chenljjj/stm32-env-monitor/docs/03-STM32与ESP32串口协议与调试.md

# STM32—ESP32 UART 协议与联调记录

本文档名使用中文，内容中的协议字段仍保留英文标识以匹配源码。

本文记录 `stm32-env-monitor` 当前使用的二进制 UART 协议、实际接线、ACK/网络状态机制和实测调试过程。STM32 负责采样和本地显示；ESP32 负责网关处理，并将有效采样加入 FreeRTOS 队列后交给 MQTT/TLS 模块。

STM32 侧现同样运行 FreeRTOS：`SensorTask` 将采样快照投递给 `LinkTask`，由后者负责协议发送、ACK 解析后的状态维护与超时重传。因此采样与通信恢复过程不会阻塞 OLED 刷新。

## 1. 通信通道与接线

两个 UART 通道相互独立：

```text
STM32 USART2 (PA2/PA3) ←→ CH340 / PC 文本日志
STM32 USART1 (PA9/PA10) ←→ ESP32 UART2 (GPIO25/GPIO26) 二进制协议
ESP32 UART0 (GPIO1/GPIO3) ←→ CP2102 / PC 烧录和日志
```

| 信号 | STM32F103C8T6 | ESP32 DevKitC | 方向 |
| --- | --- | --- | --- |
| 数据发送 | PA9 / USART1_TX | GPIO25 / UART2_RX | STM32 → ESP32 |
| 数据返回 | PA10 / USART1_RX | GPIO26 / UART2_TX | ESP32 → STM32 |
| 参考地 | GND | GND | 双向共地 |

双方均采用 `115200-8-N-1`、无校验、无硬件流控。两块板通过各自 USB 供电时，只连接两根 UART 信号线和一根 GND；不连接两块板之间的 `3.3V`、`5V` 或 `VIN`。两端 GPIO 都是 3.3 V 逻辑电平。

## 运行时验证结论

FreeRTOS 迁移后已在实板验证：STM32 采样日志连续、OLED 正常刷新、ESP32 可持续接收并回 ACK，`ack` 连续递增且 `ackerr=0`。这说明任务间快照传递未改变既有帧格式，USART1 中断接收和协议重传路径仍然可用。

## 2. 帧格式与校验

```text
+--------+--------+---------+------+-------------+-------------+---------+-------+
| SOF0   | SOF1   | Version | Type | Sequence    | Payload Len | Payload | CRC16 |
+--------+--------+---------+------+-------------+-------------+---------+-------+
| 0xA5   | 0x5A   | 1 byte  | 1 B  | uint16, LE  | uint16, LE  | 0~64 B  | 2 B   |
+--------+--------+---------+------+-------------+-------------+---------+-------+
```

- 协议版本：`0x01`。
- 多字节字段：显式小端序；不直接发送 C 结构体，避免填充、对齐和端序问题。
- 最大载荷：64 字节。
- CRC：CRC-16/CCITT-FALSE，`poly=0x1021`、`init=0xFFFF`、无反射、`xorout=0x0000`。
- CRC 覆盖 `Version` 至 `Payload`，不包含帧头和 CRC 自身。

两端均用逐字节状态机解析。版本、载荷长度或 CRC 任一项不合法即丢弃该帧并重新寻找帧头。

## 3. 消息与载荷

| 名称 | 值 | 方向 | 当前用途 |
| --- | ---: | --- | --- |
| `ENV_REPORT` | `0x01` | STM32 → ESP32 | 每秒上报一次环境采样快照。 |
| `PING` | `0x02` | 预留 | 后续链路探测。 |
| `ACK` | `0x80` | ESP32 → STM32 | 确认已处理 `ENV_REPORT`。 |
| `NET_STATUS` | `0x81` | ESP32 → STM32 | 回传 Wi-Fi/MQTT 状态、变化原因和断线计数。 |
| `PONG` | `0x82` | 预留 | 后续响应 `PING`。 |

`ENV_REPORT` 载荷固定 40 字节：

| 偏移 | 字段 | 类型 | 说明 |
| ---: | --- | --- | --- |
| 0 | `uptime_ms` | `uint32` | STM32 启动后的毫秒数。 |
| 4 | `sample_sequence` | `uint32` | 采样序号。 |
| 8 | `temperature_milli_c` | `int32` | 温度，单位 `milli °C`。 |
| 12 | `humidity_milli_rh` | `uint32` | 湿度，单位 `milli %RH`。 |
| 16 | `illuminance_milli_lux` | `uint32` | 照度，单位 `milli lx`。 |
| 20 | `valid_flags` | `uint8` | bit0 温湿度有效，bit1 照度有效，bit2 OLED 已就绪。 |
| 21、22 | 状态 | `uint8` | AHT20 与 BH1750 最近 HAL 状态。 |
| 23 | `reserved` | `uint8` | 当前写 0。 |
| 24、28、32、36 | 错误计数 | `uint32` | 两个传感器的通信错误和数据异常次数。 |

`ACK` 载荷固定 4 字节：偏移 0~1 是被确认的 STM32 帧序号（`uint16` 小端），偏移 2 是被确认类型（当前必须为 `ENV_REPORT`），偏移 3 是处理结果。

| ACK 结果 | 含义 |
| ---: | --- |
| `0x00` | 帧校验通过且 `ENV_REPORT` 已成功解包。 |
| `0x01` | 消息类型暂不支持。 |
| `0x02` | 消息类型已知，但载荷长度或格式无效。 |

ACK 只确认 UART 协议处理，不表示数据已经进入 ESP-MQTT outbox，更不表示 Broker 已返回 PUBACK。

`NET_STATUS` 载荷固定 12 字节：

| 偏移 | 字段 | 类型 | 说明 |
| ---: | --- | --- | --- |
| 0 | `flags` | `uint8` | bit0：Wi-Fi 已连接；bit1：MQTT 已连接；其余位必须为 0。 |
| 1 | `reason` | `uint8` | 本次快照的触发原因，见下表。 |
| 2~3 | `reserved` | `uint16` | 保留，必须为 0。 |
| 4~7 | `wifi_disconnect_count` | `uint32` | Wi-Fi 从已连接变为断开的累计次数，小端序。 |
| 8~11 | `mqtt_disconnect_count` | `uint32` | MQTT 从已连接变为断开的累计次数，小端序。 |

| `reason` | 含义 |
| ---: | --- |
| `0` | ESP32 状态模块启动。 |
| `1` | Wi-Fi 已获得网络连接。 |
| `2` | Wi-Fi 从已连接状态断开。 |
| `3` | MQTT 会话已连接。 |
| `4` | MQTT 会话从已连接状态断开。 |

ESP32 在状态变化时立即发送 `NET_STATUS`；此外每处理 10 个环境样本发送一次当前快照。周期快照用于处理 STM32 晚启动、复位或偶发丢帧后的状态恢复。ACK 与 `NET_STATUS` 可能由不同任务触发，因此 ESP32 使用发送互斥锁保证每个二进制帧连续写入 UART。

## 4. ACK 状态机

1. STM32 为新采样生成序号为 `N` 的 `ENV_REPORT`。
2. STM32 **在发送前**写入 `expected_ack_sequence=N` 并置 `awaiting_ack=1`。
3. STM32 通过 USART1 发送；若发送失败，撤销等待状态。
4. ESP32 完成 CRC、长度和 `ENV_REPORT` 语义解包后，立即回传携带 `N` 的成功 ACK；异常载荷返回非零结果。
5. STM32 在 USART1 单字节接收中断中解析 ACK，校验长度、确认类型、序号和结果码。
6. 校验通过则 `ack_count` 加一；失败则 `ack_error_count` 加一并保留诊断信息。

ESP32 的 UART2 读取一次最多等待 20 ms。这样单帧不足接收缓冲区长度时，也不会因长时间等待收满而延迟 ACK。

## 5. ACK 超时、重传与去重

STM32 发送成功后缓存完整 `ENV_REPORT` 帧，等待 ACK。若 200 ms 内没有收到匹配的成功 ACK，则以**相同帧内容和相同 UART 序号**重传；最多额外发送 3 次。第三次重传仍超时后放弃该帧，并在下一个采样周期生成新帧。传感器采样、OLED 更新和日志输出不会因此停止。

ESP32 对连续到达且 UART 序号等于上一有效环境帧的报文，仍立即返回成功 ACK，但不重复写入 MQTT 队列。因此丢失 ACK 时，STM32 能恢复链路，而云端不会因为相同重传帧收到重复遥测。

若 ESP32 返回合法但非零的 ACK 结果（类型不支持或载荷无效），STM32 记录 ACK 语义错误并结束等待；重传相同错误载荷没有意义。CRC 错误、丢帧或没有 ACK 等不确定情况才走超时重传路径。

`NET_STATUS` 已完成硬件验证：Wi-Fi 被断开时 STM32 显示 `net=--`，ESP32 恢复 IP 后显示 `net=W-`，MQTT/TLS 会话恢复后显示 `net=WM`。本轮测试未刻意断开 ESP32→STM32 的 ACK 线路，因此 UART 超时重传和重复帧去重仍保留为后续独立故障注入项。

## 6. 链路诊断与实测结果

STM32 USART2 日志包含：

```text
uart1=OK txerr=0 ack=11 rxerr=0 ackerr=0 exp=11 got=10 af=0x00 retry=0 timeout=0 drop=0 pending=0 net=WM ns=3 nerr=0 wd=0 md=0 nr=3
```

| 字段 | 说明 |
| --- | --- |
| `uart1` / `txerr` | 当前帧发送状态与累计发送失败次数。 |
| `ack` | 通过完整校验的 ACK 累计次数。 |
| `rxerr` | UART 接收或协议解析错误累计次数。 |
| `ackerr` | ACK 语义校验失败累计次数。 |
| `exp` | 当前刚发送帧的期待 ACK 序号。 |
| `got` | 最近收到 ACK 所确认的序号。 |
| `af` | 最近 ACK 的错误标志；`0x00` 表示通过。 |
| `retry` | 已执行的累计重传次数。 |
| `timeout` | 等待 ACK 超过 200 ms 的累计次数。 |
| `drop` | 3 次重传耗尽后放弃的累计帧数。 |
| `pending` | `1` 表示当前日志打印时本轮缓存帧仍等待 ACK，`0` 表示没有待确认帧。由于日志在发送后、ACK 处理前输出，稳定链路上经常观察到 `1`，应结合下一轮 `ack` 是否递增判断。 |
| `net` | `W` 表示 Wi-Fi 已连接，`M` 表示 MQTT 已连接，未连接位置显示 `-`。 |
| `ns` / `nerr` | 通过语义校验的网络状态帧数 / 无效网络状态帧数。 |
| `wd` / `md` | Wi-Fi / MQTT 从已连接变为断开的累计次数。 |
| `nr` | 最近网络状态原因，取值见 `NET_STATUS` 原因表。 |

`exp` 与 `got` 在同一行可能相差 1：日志打印时已经登记当前帧，而 `got` 通常是上一帧刚通过校验的 ACK。稳定工作的标准是 `ack` 持续递增、`rxerr=0`、`ackerr=0`、`af=0x00`。

| `af` 标志 | 含义 |
| ---: | --- |
| `0x01` | ACK 载荷长度错误。 |
| `0x02` | 被确认的消息类型错误。 |
| `0x04` | 未处于等待 ACK 状态。 |
| `0x08` | ACK 序号与期待序号不一致。 |
| `0x10` | ACK 结果码非 0。 |

2026-08-23 已完成实测：AHT20、BH1750 数据均有效，STM32 连续输出 `ack` 递增，`rxerr=0 ackerr=0 af=0x00`；ESP32 同步解析并打印温湿度、照度和有效标志。

### 6.1 三端长稳关联验证（2026-08-27）

最新 CSV 以真实设备 `sample=8` 至 `16075` 为范围，STM32、ESP32 和 MQTT JSON 各有 16068 条同序号记录，序号无缺口。ESP32 `uptime_ms` 从 `7084` 到 `16074084`，每相邻样本严格增加 1000 ms，覆盖 4 小时 27 分 47 秒。

全段 STM32 的 `rxerr=0`、`txerr=0`、`ackerr=0`、`retry=0`、`timeout=0`、`drop=0`、`qdrop=0/0`；ESP32 与 MQTT 记录中的传感器错误均为 0，说明协议收发、ACK 时序、去重和 MQTT 交接在该在线长稳片段内均未出现可观测异常。

## 7. 实际故障定位复盘

首次联调现象为：ESP32 能收到环境帧，STM32 `rxerr=0`，但出现 `ackerr` 增长和 `af=0x08`，且 `got` 总比 `exp` 小 1。

定位步骤：

1. `rxerr=0` 表明接线、115200 配置、帧头、长度和 CRC 均正常，排除物理层和解析层问题。
2. 增加 `exp`、`got`、`af` 诊断字段，确定问题是 ACK 序号落后一帧。
3. 对照 ESP32 日志，发现多个样本在同一 ESP 时间戳输出，说明 UART 数据被批量处理。
4. 检查 `uart_read_bytes(..., 128, pdMS_TO_TICKS(1000))`：单帧不足 128 字节时，最多会等待 1000 ms，ACK 因此落后一个采样周期。
5. 将最大等待改为 20 ms，并把 ESP32 的 ACK 发送移动到日志输出之前；STM32 同时改为发送前登记期待序号。

修复后链路稳定。以后按以下顺序排查：供电与共地 → TX/RX 交叉和串口参数 → STM32/ESP32 独立日志 → `rxerr` → `ackerr` → `exp/got/af`。源码修改后必须分别 Build 和 Flash；仅复位不会更新 Flash 中的程序。

## 8. 网络阶段现状

ESP32 已把有效 `ENV_REPORT` 放入容量为 32 条的 FreeRTOS 队列；独立任务等待 MQTT 连接后转成 JSON，并使用 QoS 1 发布。队列满时丢弃最新样本并累计 `queue_overflow_count`，避免无界内存增长。日志每 10 个样本输出连接状态、断线次数、待发数量、溢出、发布接受、发布错误、放弃和 PUBACK 统计。

设备端已实测 Wi-Fi 连接、TLS MQTT 连接、MQTTX 遥测订阅、`NET_STATUS` 回传及短时断网恢复。断网期间 STM32 的 ACK 仍连续递增，说明“ESP32 已接收 UART 帧”与“云端会话状态”被正确解耦。后续仍需验证：Broker 单独不可达、STM32 单独复位后的快照恢复、断开 ESP32→STM32 TX 线导致的 ACK 超时/重传，以及重复帧不重复上云。

## 9. 本地网络状态可视化

STM32 收到合法 `NET_STATUS` 后，将 `flags` 缓存在链路状态中，并随下一份显示快照交给 `DisplayTask`。OLED 不直接访问网络，也不需要增加 I2C 设备；它只显示 UART 协议已经回传的状态：

```text
WIFI:ON MQTT:ON
```

其中 `WIFI:ON` 对应 bit0，`MQTT:ON` 对应 bit1。Wi-Fi 断开、已获取 IP 但 MQTT 尚未建连、MQTT 恢复的典型显示状态依次为 `--`、`W-`、`WM`，与 USART2 日志中的 `net` 字段一致。

该功能只修改 STM32 显示层：ESP32 在此前已发送相同格式的 `NET_STATUS`，因此无需为 OLED 排版变化重新构建或烧录 ESP32。OLED 布局已改为居中、统一字号的温度/湿度/照度三行与一行网络状态；重新烧录 STM32 后应在实板确认最终排版效果。
