chenljjj/stm32-env-monitor/firmware/stm32-env-monitor/Core/Src/app_link.c

#include "app_link.h"

#include <string.h>

#define APP_PROTOCOL_ACK_PAYLOAD_LENGTH 4U

static void app_link_start_receive(app_link_t *link)
{
  if ((link == NULL) || (link->huart == NULL))
  {
    return;
  }

  link->rx_status = HAL_UART_Receive_IT(link->huart, &link->rx_byte, 1U);
  if (link->rx_status != HAL_OK)
  {
    ++link->rx_error_count;
  }
}

static uint16_t app_link_get_u16_le(const uint8_t *buffer)
{
  return (uint16_t)buffer[0] | ((uint16_t)buffer[1] << 8U);
}

static void app_link_handle_ack(app_link_t *link)
{
  const uint8_t *payload = link->frame.payload;
  uint16_t acknowledged_sequence = 0U;
  uint8_t error_flags = 0U;

  if (link->frame.payload_length != APP_PROTOCOL_ACK_PAYLOAD_LENGTH)
  {
    error_flags |= APP_LINK_ACK_ERROR_LENGTH;
  }
  else
  {
    acknowledged_sequence = app_link_get_u16_le(payload);
    link->last_received_ack_sequence = acknowledged_sequence;
    link->last_received_ack_type = payload[2];
    link->last_received_ack_result = payload[3];

    if (payload[2] != APP_PROTOCOL_TYPE_ENV_REPORT)
    {
      error_flags |= APP_LINK_ACK_ERROR_TYPE;
    }
    if (link->awaiting_ack == 0U)
    {
      error_flags |= APP_LINK_ACK_ERROR_NOT_WAITING;
    }
    if (acknowledged_sequence != link->expected_ack_sequence)
    {
      error_flags |= APP_LINK_ACK_ERROR_SEQUENCE;
    }
    if (payload[3] != 0U)
    {
      error_flags |= APP_LINK_ACK_ERROR_RESULT;
    }
  }

  link->last_ack_error_flags = error_flags;
  if (error_flags != 0U)
  {
    /* 对端已明确拒绝载荷时，重传相同内容不会改变结果。 */
    if (error_flags == APP_LINK_ACK_ERROR_RESULT)
    {
      link->awaiting_ack = 0U;
    }
    ++link->ack_error_count;
    return;
  }

  link->last_ack_sequence = acknowledged_sequence;
  link->last_ack_result = payload[3];
  link->awaiting_ack = 0U;
  ++link->ack_count;
}

static void app_link_handle_net_status(app_link_t *link)
{
  app_protocol_net_status_t status;

  if (app_protocol_unpack_net_status(&link->frame, &status) != HAL_OK)
  {
    ++link->net_status_error_count;
    return;
  }

  link->network_flags = status.flags;
  link->last_network_reason = status.reason;
  link->wifi_disconnect_count = status.wifi_disconnect_count;
  link->mqtt_disconnect_count = status.mqtt_disconnect_count;
  ++link->net_status_count;
}

void app_link_init(app_link_t *link, UART_HandleTypeDef *huart)
{
  if ((link == NULL) || (huart == NULL))
  {
    return;
  }

  (void)memset(link, 0, sizeof(*link));
  link->huart = huart;
  link->rx_status = HAL_BUSY;
  app_protocol_parser_init(&link->parser);
  app_link_start_receive(link);
}

/* 先登记期待的 ACK，避免 ESP32 回包早于发送函数返回。 */
void app_link_arm_env_report_ack(app_link_t *link, uint16_t sequence)
{
  if (link != NULL)
  {
    link->expected_ack_sequence = sequence;
    link->awaiting_ack = 1U;
  }
}

/* 发送失败时撤销期待状态，避免旧序号影响后续确认。 */
void app_link_cancel_env_report_ack(app_link_t *link)
{
  if (link != NULL)
  {
    link->awaiting_ack = 0U;
  }
}

void app_link_on_uart_rx_complete(app_link_t *link, UART_HandleTypeDef *huart)
{
  app_protocol_parse_result_t result;

  if ((link == NULL) || (huart != link->huart))
  {
    return;
  }

  result = app_protocol_parser_input(&link->parser, link->rx_byte, &link->frame);

  if (result == APP_PROTOCOL_PARSE_FRAME)
  {
    ++link->received_frame_count;
    if (link->frame.type == APP_PROTOCOL_TYPE_ACK)
    {
      app_link_handle_ack(link);
    }
    else if (link->frame.type == APP_PROTOCOL_TYPE_NET_STATUS)
    {
      app_link_handle_net_status(link);
    }
  }
  else if (result != APP_PROTOCOL_PARSE_NONE)
  {
    ++link->rx_error_count;
  }

  app_link_start_receive(link);
}

void app_link_on_uart_error(app_link_t *link, UART_HandleTypeDef *huart)
{
  if ((link == NULL) || (huart != link->huart))
  {
    return;
  }

  ++link->rx_error_count;
  app_protocol_parser_reset(&link->parser);
  app_link_start_receive(link);
}
