chenljjj/stm32-env-monitor/(commit log)

2026-08-19 docs: 初始化项目规划与开发文档
2026-08-19 docs: 调整项目简介
2026-08-19 新增 STM32F103 CubeMX 可编译基线工程
2026-08-19 实现 PC13 LED 闪烁和 USART1 启动日志
2026-08-19 清理预生成参考代码和过早设计文档
2026-08-19 封装串口日志模块并完善状态指示
2026-08-21 接入I2C传感器采集与OLED显示
2026-08-22 完善串口通信协议并建立ESP32网关工程
2026-08-22 忽略本地语言服务配置
2026-08-22 完善项目技术文档
2026-08-22 完善STM32与ESP32串口协议联调
2026-08-23 修复串口ACK时序并完善联调文档
2026-08-24 完成端到端联网与断网恢复验证
    [partitions.csv]
2026-08-24 迁移STM32至FreeRTOS多任务架构
2026-08-24 增加FreeRTOS运行时资源监控
2026-08-24 优化OLED联网状态显示
2026-08-25 更新项目README与运行时文档
2026-08-25 补充上位机仓库链接
2026-08-27 更新长稳测试记录与公开文档
2026-08-27 补充硬件接线实物图与上位机入口
