chenljjj/stm32-env-monitor/(notices)

Notices in the files:
firmware/stm32-env-monitor/Core/Src/main.c:
Copyright (c) 2026 STMicroelectronics.
All rights reserved.
This software is licensed under terms that can be found in the LICENSE file
